hamid-martinez/LARC/README.md

# Robot project

<p align="justify"> The robot project named LARC consists of a container transporting system. The system is composed by a main robot that does all the transporting of the containers, a main conveyor belt that is in charge of identifying the containers' information and two transporting conveyors where the robot will place the already identified containers.</p>

<p align="justify"> The main robot is driven with onmidirectional wheels controlled by dc motors with encoders, it has a platform that can be moved up and down with the help of a stepper motor and it contains electromagnets to attach the containers. The main circuit contains the necessary components and connections for the drivers and signals.</p>

<p align="justify"> To control the robot, the main program is loaded into an Arduino Mega, which is connected to a Raspberry Pi that has the necessary commads to send to the arduino through serial communication.</p>

<p align="justify"> The main conveyor belt is driven by a dc motor and even if it has encoders, they are not used. The main conveyor has another Raspberry Pi that has a Pi Camera attached to read the QR codes of the containers. It also has a sensor to indicate when a conveyor is waiting to be transported.</p>

<p align="justify"> The Raspberry Pi's communicate through a google cloud service from a spread sheet. Using the gspread library from python, the computers are able to manipulate the data from the sheet and read data from it.</p>

<p align="justify"> To start, the main conveyor will move a container until the sensor detects it. Once it has, it sends a signal to the spread sheet to tell the main robot to go pick up the container. The robot then reads the signal and moves towards the conveyor, it picks up the conveyor and places it in front of the camera. It then sends a signal that it is ready to scan. Which the main conveyor reads from the google sheet and it scans the QR code of the container. Once the operation is complete, it will store the information of the QR code in the spread sheet, keeping an inventory. The main robot can then read from the information on the QR code, where it should place the container, either band 1 or 2. Once it knows it places the container in the corresponding band and then returns to wait for another container.</p>

The link to the google spread sheet is the next link (requires permission):
https://docs.google.com/spreadsheets/d/132iB4omVbyltYzKWI_OyOcBsnX106o9ql_H0pjo2T8Y/edit#gid=0

# Repository structure

<p align="justify"> The repo is devided into three main categories, each one has a folder. The first is the mechanical, where all the CAD files are included for the main robot and the conveyors.</p>

<p align="justify"> The second part is the electrical, where the circuit for the main robot and the conveyor, as well as the components necessary to build it can be found. </p>

<p align="justify"> The last part consists of the code. The code is structured in classes, each class handles a specific task for the robot. Inside it also has the main arduino code for the robot and the main python files for the conveyor and the robot.</p>

# Robot and conveyors overview

## Main robot
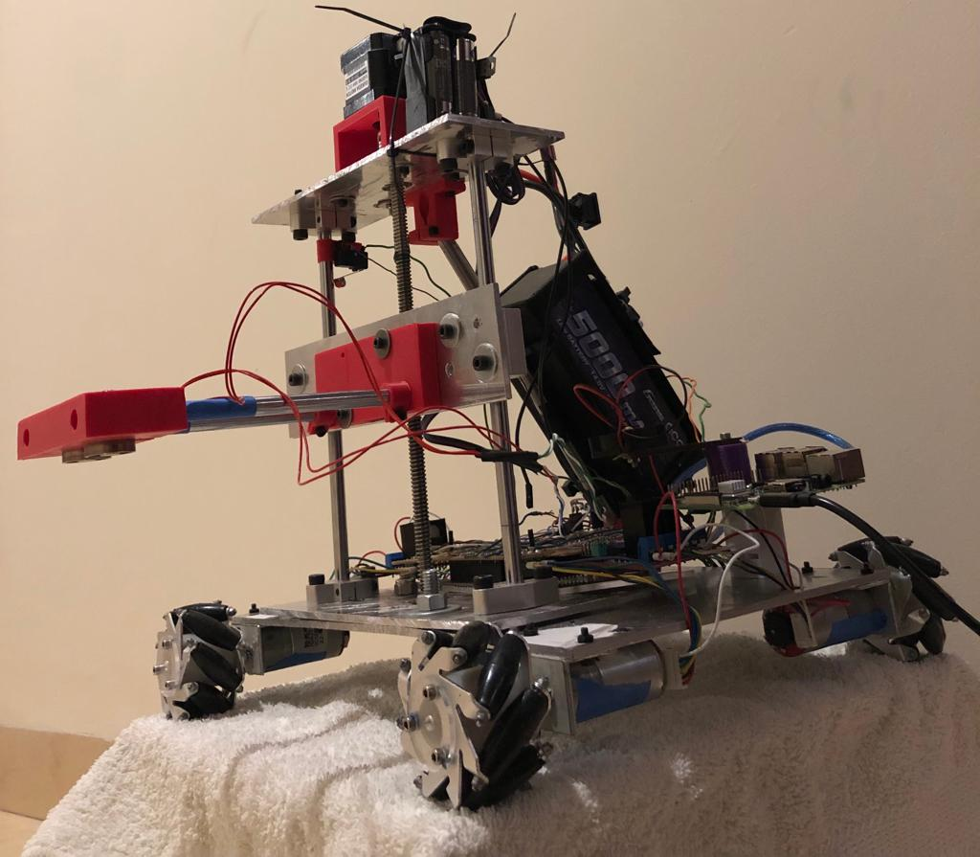
[picture p1: pictures/main_robot_side1.jpeg]
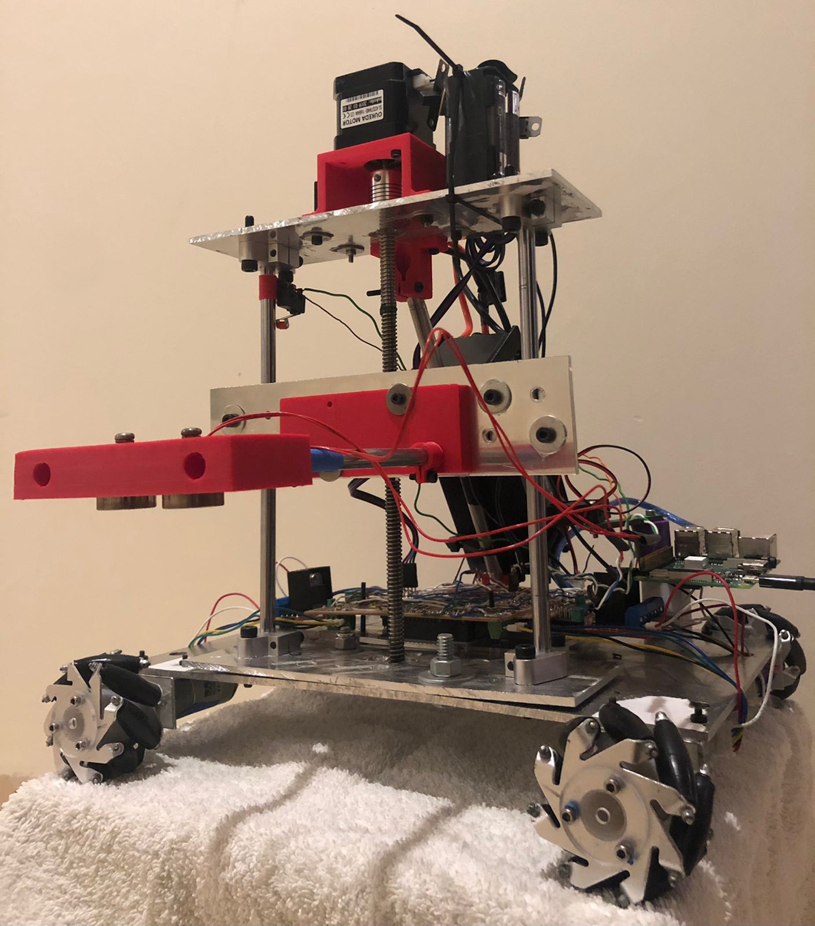
[picture p2: pictures/main_robot_side2.jpeg]


## Main conveyor
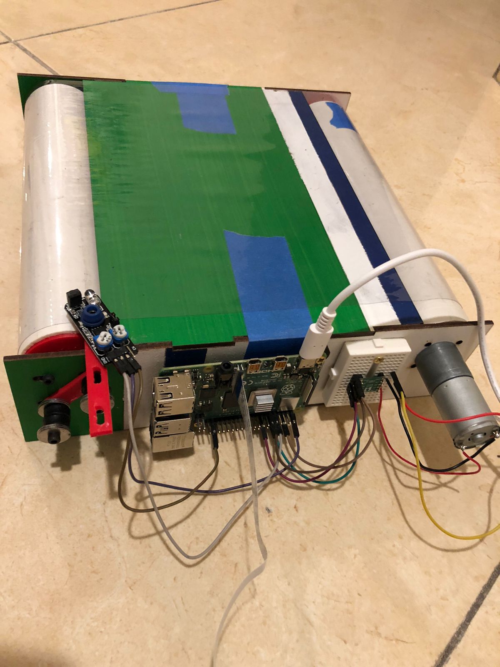
[picture p3: pictures/main_conveyor_side1.jpeg]
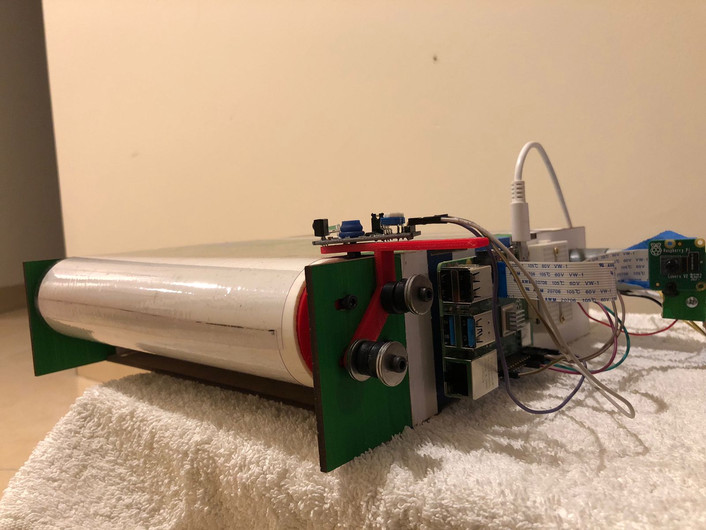
[picture p4: pictures/main_conveyor_side2.jpeg]


## Steel container painted and with QR code
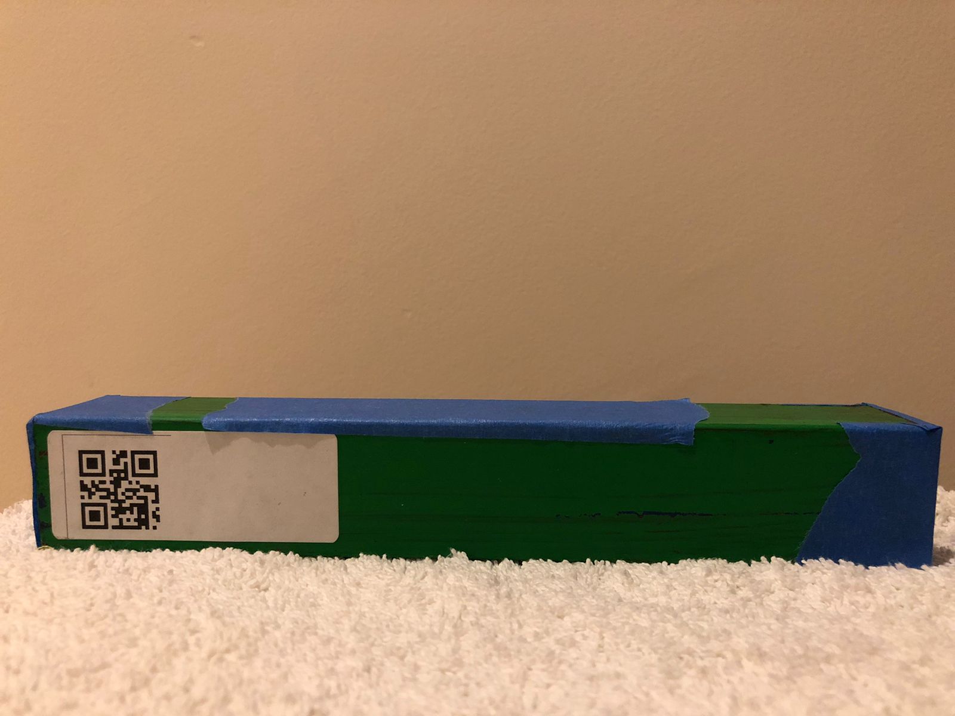
[picture p5: pictures/container.jpeg]


## Placement conveyors
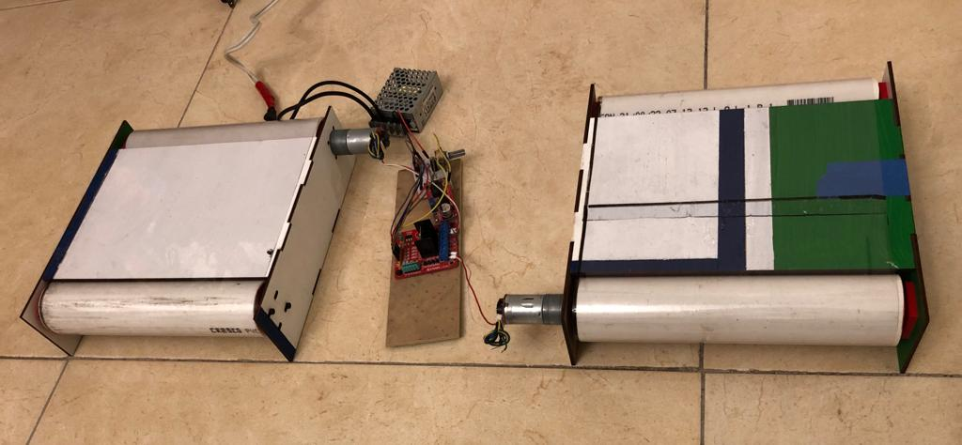
[picture p6: pictures/placement_conveyors.jpeg]


## Complete placement
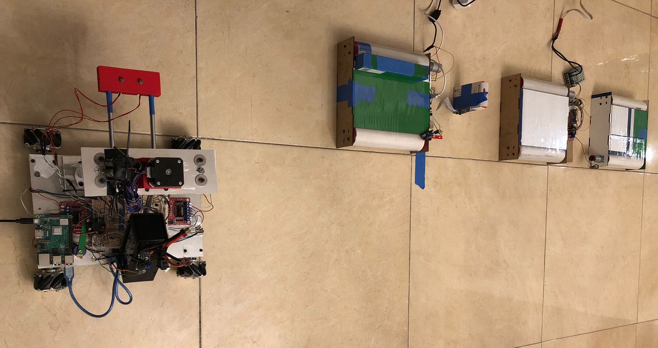
[picture p7: pictures/complete_placement1.jpeg]
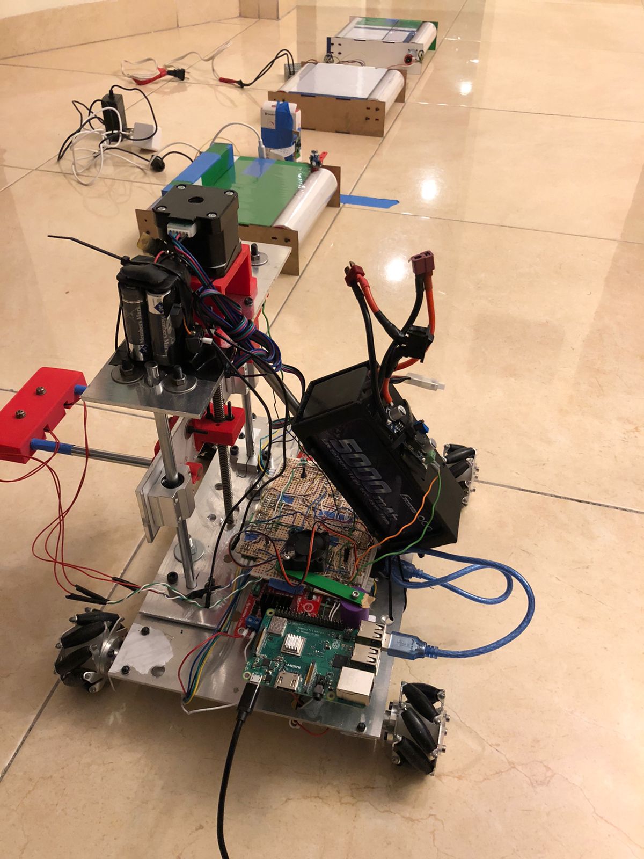
[picture p8: pictures/complete_placement2.jpeg]
 

## Video demonstration link
https://www.youtube.com/watch?v=me1BS7kdDBs
