hamid-martinez/LARC/mechanical/README.md

# Mechanical
Some important mechanical materials can be found in the excel file. Check the CAD files for further measurements and references.

All the CAD files are available in the zip folder, it also includes the CAD files for the conveyors.

The main robot design is as follows:

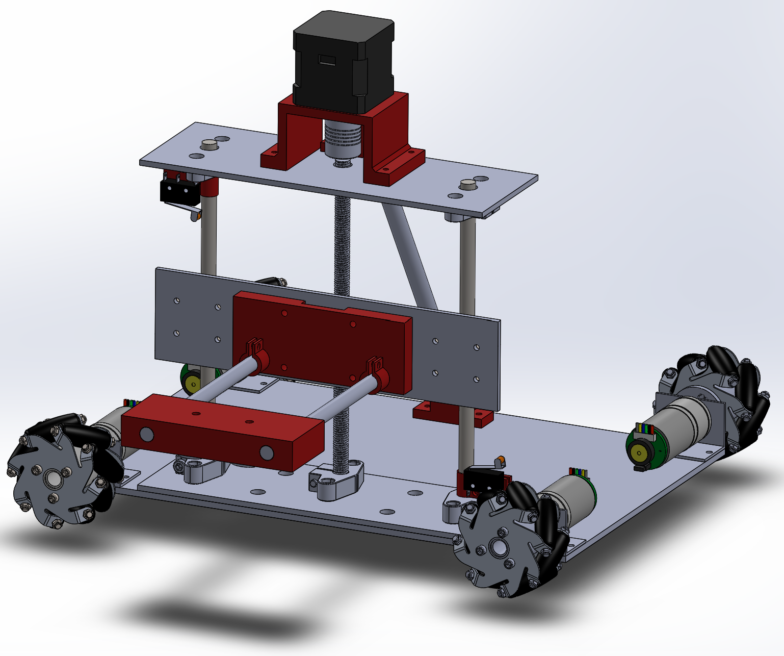
[picture p9: mechanical/main_robot_cad.png]

  
The conveyors were designed as follows:
  
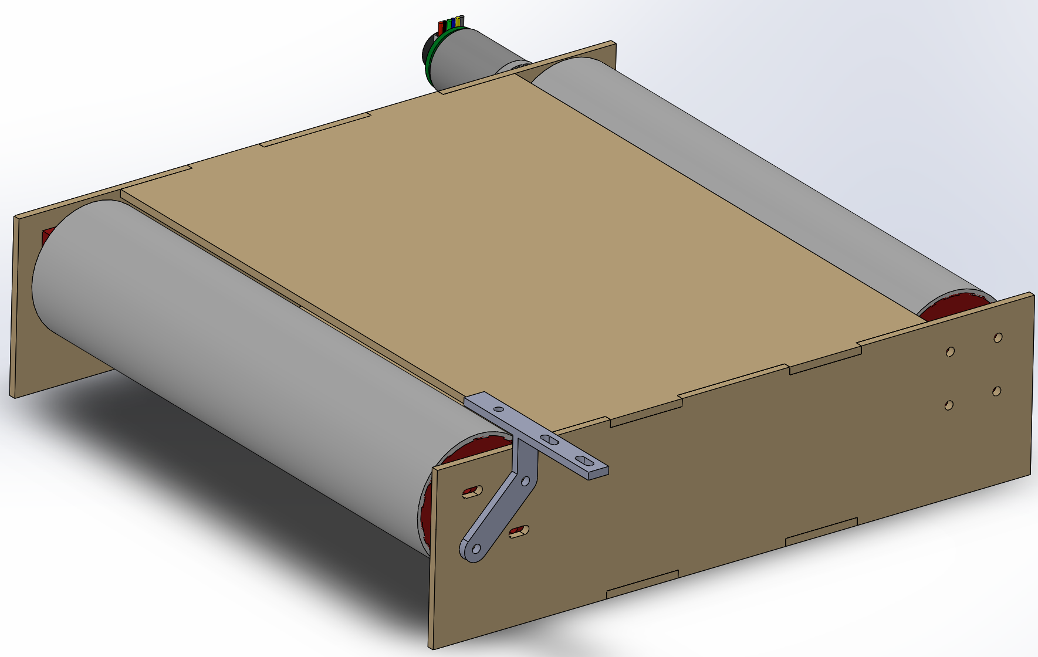
[picture p10: mechanical/main_conveyor_cad.png]
