hamid-martinez/LARC/electrical/robot_conveyor_materials.xlsx

Component | Value | Needed quantity | Link
Stepper motor | N/A | 1 | https://articulo.mercadolibre.com.mx/MLM-549845943-motor-a-pasos-nema-17-stepper-cnc-router-impresora-3d-arduino-a4988-15a-nuevo-36v-12v-_JM
Stepper motor driver | DRV8825 | 1 | https://articulo.mercadolibre.com.mx/MLM-657252932-drv8825-driver-motor-pasos-impresora-3d-cnc-arduino-_JM
Capacitor | 100uF | 1 | https://articulo.mercadolibre.com.mx/MLM-944525121-capacitor-electrolitico-100uf-16v-50v-105-c-10-piezas-_JM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
Limit switch | N/A | 1 | https://articulo.mercadolibre.com.mx/MLM-793119122-10-limit-switch-interruptor-final-carrera-kw11-3z-arduino-_JM
Resistor | 10K | 1 | https://articulo.mercadolibre.com.mx/MLM-660627026-200-resistencias-14-w-1-pelicula-metalica-varios-valores-_JM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
Motor driver | L293D | 1 | https://articulo.mercadolibre.com.mx/MLM-606062197-puente-h-l293d-_JM
Electromagnet | N/A | 2 | https://articulo.mercadolibre.com.mx/MLM-555357699-electroiman-iman-electrico-12v-25kg-electromagneto-arduino-_JM
DC motor with encoder | N/A | 4 | https://articulo.mercadolibre.com.mx/MLM-962990906-gm-25-370-encoder-12-v-dc-140-rpm-con-motor-_JM
DC motor driver | L298N | 2 | https://articulo.mercadolibre.com.mx/MLM-592272986-tarjeta-para-control-de-motores-cc-l298n-ard-341-_JM
Arduino Mega | N/A | 1 | https://articulo.mercadolibre.com.mx/MLM-830115330-tarjeta-mega-2560-smd-compatible-con-arduino-_JM
Raspberry Pi 4 or 3B | N/A | 2 | https://www.amazon.com.mx/LANDZO-Raspberry-Pi-Modelo-GB/dp/B08R87H4RR?hvadid=451079496715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
Raspberry Pi Camera | N/A | 1 | https://articulo.mercadolibre.com.mx/MLM-777425519-camara-raspberry-pi-4-b-v2-8mp-1080p-original-pi4-pi3-b-plus-_JM
Distance sensor | N/A | 1 | https://articulo.mercadolibre.com.mx/MLM-791224550-5-piezas-modulo-tcrt5000-sensor-optico-reflectivo-arduino-pi-_JM
Lipo Battery | 5000mAh | 1 | https://articulo.mercadolibre.com.mx/MLM-1333365691-bateria-lipo-gens-ace-short-size-5000-mah-2s-74v-50c-xt60-_JM
Step down module | N/A | 1 | https://articulo.mercadolibre.com.mx/MLM-1326975077-10-pza-modulo-regulador-de-voltaje-ajustable-lm2596-125-30v-_JM
5V regulator | LM7805 | 1 | https://articulo.mercadolibre.com.mx/MLM-1498373719-3-piezas-regulador-de-voltaje-5v-lm7805-7805-l7805-l7805cv-_JM
Alkaline battery | AA | 4 or 8 | https://www.mercadolibre.com.mx/pila-recargable-steren-ni-mh-bat-nm-aa-cilindrica-pack-de-4-unidades/p/MLM14618874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
Omnidirectinal wheel | N/A | 4 | https://articulo.mercadolibre.com.mx/MLM-1426694931-llanta-omnidireccional-mecanum-80mm-set-4-piezas-robotica-_JM
Single motor driver | MAX14870 | 1 | https://articulo.mercadolibre.com.mx/MLM-705401250-controlador-para-motor-max14870-17a-electronica-arduino-_JM
