hamid-martinez/LARC/mechanical/robot_conveyor_mechanical_materials.xlsx

Component | Value | Needed quantity | Link
Linear ball bearing | N/A | 2 | https://articulo.mercadolibre.com.mx/MLM-1358126870-4-pzs-rodamiento-lineal-balero-sc8uu-impresora-8mm-3d-camisa-_JM
Shaft support | N/A | 4 | https://articulo.mercadolibre.com.mx/MLM-862363144-soporte-de-pared-shf8-para-eje-lineal-de-8mm-sc8uu-lm8uu-_JM
PVC pipe | N/A | 2 meters | Consult CAD files
Threaded rod | N/A | 1 | https://articulo.mercadolibre.com.mx/MLM-760595795-m893-thsl-400mm-8d-tornillo-acme-husillo-varilla-roscada-2a-_JM
Linear rod | N/A | Consult CAD files | https://articulo.mercadolibre.com.mx/MLM-591128032-varilla-lisa-guia-lineal-eje-acerado-flecha-8mm-l400mm-_JM
