hamid-martinez/LARC/program/qr_scanner/qr_code_scanner.py

import cv2
from picamera import PiCamera
from time import sleep

# Based on https://practicaldatascience.co.uk/data-science/how-to-read-qr-codes-in-python-using-opencv
# Suggested location for qr_code: "/home/pi/Desktop/git-larc/LARC/program/qr_scanner/qr_code.png"

class qr_code_scanner():

    def __init__(self, file_location):
        
        self.file_location = file_location

    def take_picture(self):

        camera = PiCamera()
        camera.capture(self.file_location)

        return f"Picture taken at {self.file_location}"

    def read_qr_code(self):

        try:
            img = cv2.imread(self.file_location)
            detect = cv2.QRCodeDetector()
            value, points, straight_qrcode = detect.detectAndDecode(img)
            sleep(1)
            
            return value

        except:
            return ""

# TEST
""" qr = qr_code_scanner("/home/pi/Desktop/git-larc/LARC/program/qr_scanner/qr_code.png")
qr.take_picture()
print(qr.read_qr_code()) """
