hamid-martinez/LARC/(commit log)

2022-10-08 Added current version of arduino code
2022-10-08 Added last dc motor movements
2022-10-09 stepper test
2022-10-09 Testing for stepper
2022-10-09 changes to stepper
2022-10-10 Added stepper functionality
2022-10-18 tunned PID and added pi comm
2022-10-18 limit switch funtionality
2022-10-18 Added stepper limit functionality
2022-10-31 PID tunning
2022-10-31 PID tunning 2
2022-10-31 Added esp32 cam file
2022-10-31 esp32cam code
2022-11-01 PID mods
2022-11-01 PID update 2
2022-11-05 added env and qr codes to print
    [pyvenv.cfg]
2022-11-06 Added camera control
2022-11-07 enhanced qr code, mode to camera focus
2022-11-10 Added gpio control for conveyor
2022-11-10 added conveyor control with sensor
2022-11-11 AD-main_bot py code,MOD-arduino code
2022-11-14 Mod: Circuit adjusted code
2022-11-15 Beginning of conveyor routine
2022-11-16 Working stage: PID individually (T1,2,3,4)
2022-11-17 robot code pid motors
2022-11-18 no pid added
2022-11-18 no pid, testing
2022-11-18 No pid, motion until camera analysis
2022-11-26 Calibration 1
2022-11-26 Final testing conveyor 1
